Notchennie1/CDE2310_Group11/docs/Electrical work/System_Schematics.png

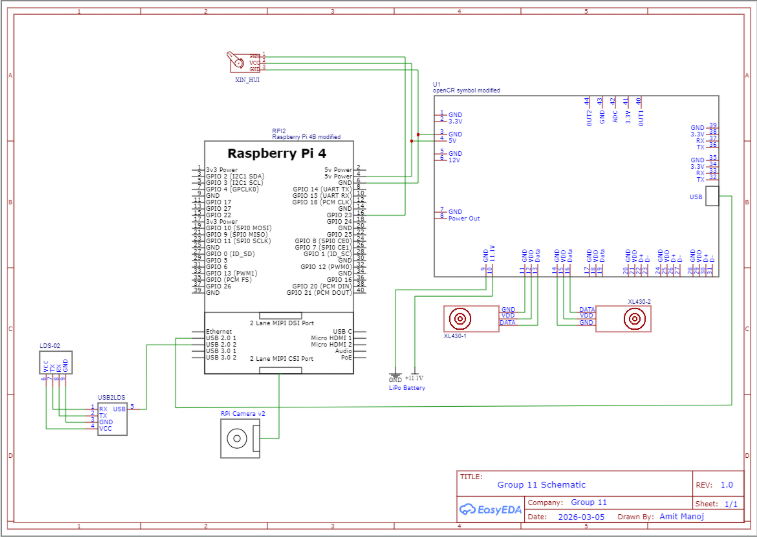
docs/Electrical work/System_Schematics.png
