Notchennie1/CDE2310_Group11/CAD/Turtlebot Assembly/Launcher Assembly.SLDASM

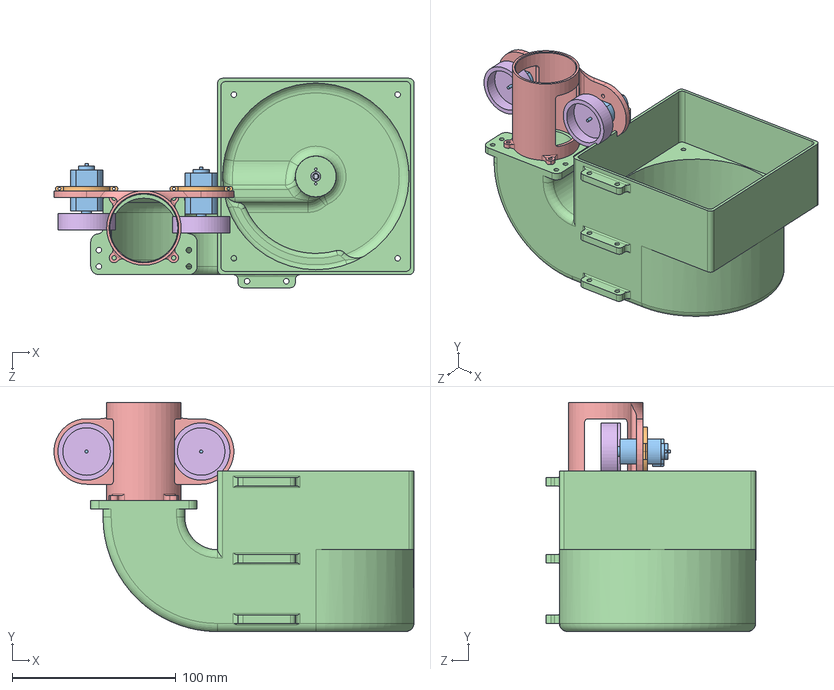
[picture p7: CAD file, 2026-04-19]
CAD/Turtlebot Assembly/Launcher Assembly.SLDASM
219.9 x 140.0 x 128.0 mm
Flywheel dummy x 2
Barrel guide
Carousell
Motor x 2
Motor Clamp x 2
Stepper Dummy
