Notchennie1/CDE2310_Group11/CAD/Turtlebot Assembly/Ball_Feeder_Full.SLDPRT

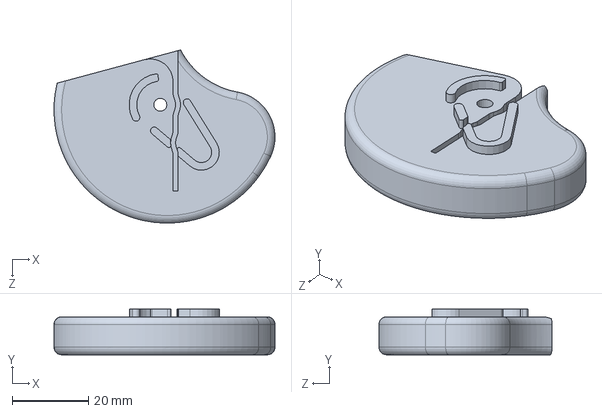
[picture p8: CAD file, 2026-04-19]
CAD/Turtlebot Assembly/Ball_Feeder_Full.SLDPRT
58.0 x 12.0 x 45.5 mm
