Notchennie1/CDE2310_Group11/CAD/Turtlebot Assembly/Motor_Support.SLDPRT

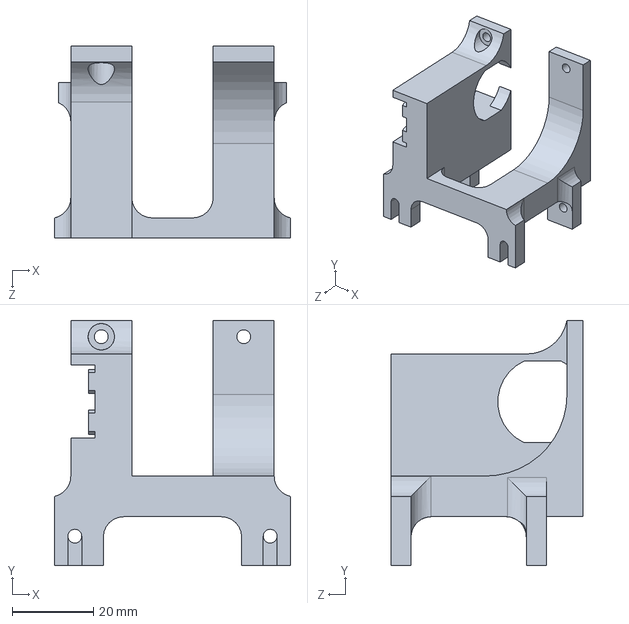
[picture p9: CAD file, 2026-04-19]
CAD/Turtlebot Assembly/Motor_Support.SLDPRT
58.0 x 60.2 x 47.3 mm
