Notchennie1/CDE2310_Group11/CAD/Turtlebot Assembly/PingPong_Ball.SLDPRT

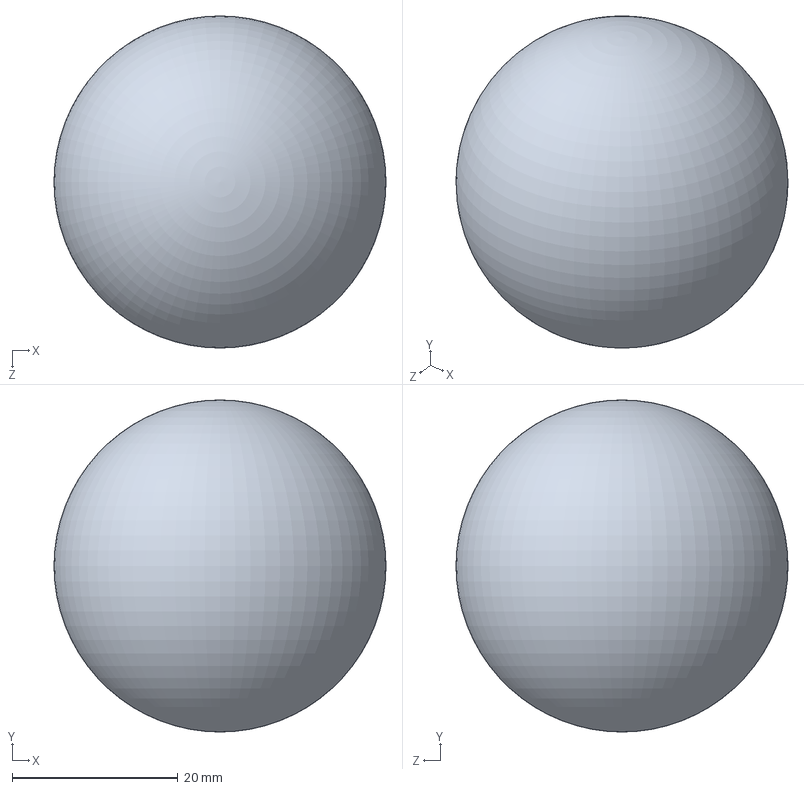
[picture p10: CAD file, 2026-04-19]
CAD/Turtlebot Assembly/PingPong_Ball.SLDPRT
40.0 x 40.0 x 40.0 mm
