Notchennie1/CDE2310_Group11/CAD/Turtlebot Assembly/Motor Clamp.SLDPRT

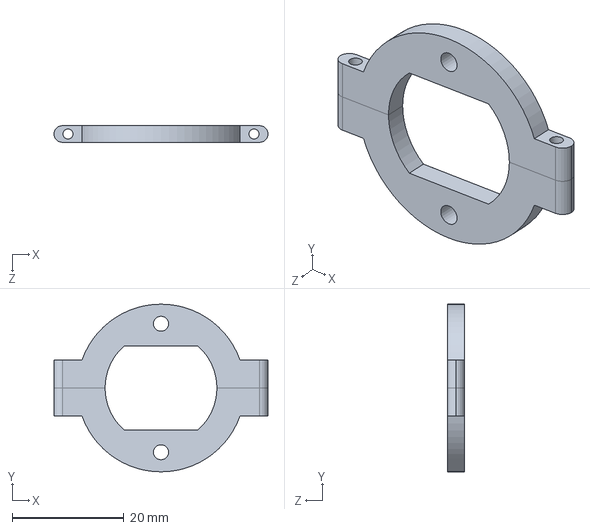
[picture p11: CAD file, 2026-04-19]
CAD/Turtlebot Assembly/Motor Clamp.SLDPRT
38.3 x 30.0 x 3.00 mm
