Notchennie1/CDE2310_Group11/CAD/Turtlebot Assembly/Clamp2.SLDPRT

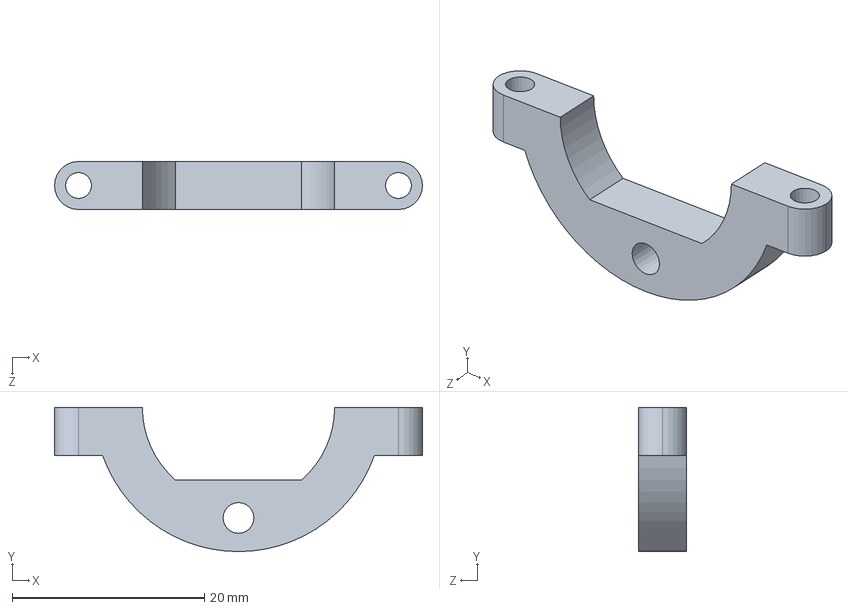
[picture p12: CAD file, 2026-04-19]
CAD/Turtlebot Assembly/Clamp2.SLDPRT
38.3 x 15.0 x 5.00 mm
