Notchennie1/CDE2310_Group11/CAD/Turtlebot Assembly/Raspberry_Dummy.SLDPRT

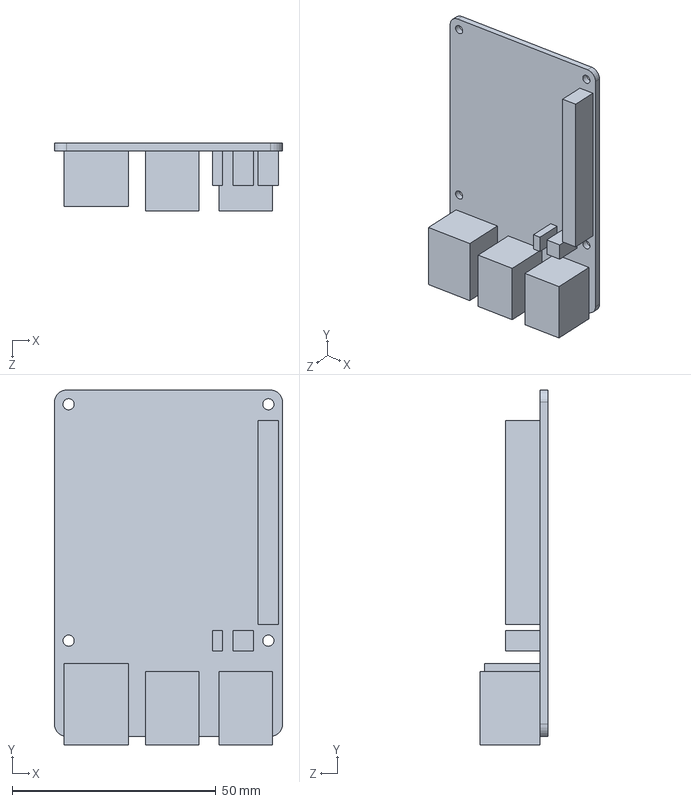
[picture p13: CAD file, 2026-04-19]
CAD/Turtlebot Assembly/Raspberry_Dummy.SLDPRT
56.0 x 87.1 x 16.8 mm
