Notchennie1/CDE2310_Group11/CAD/Turtlebot Assembly/Rotor.SLDPRT

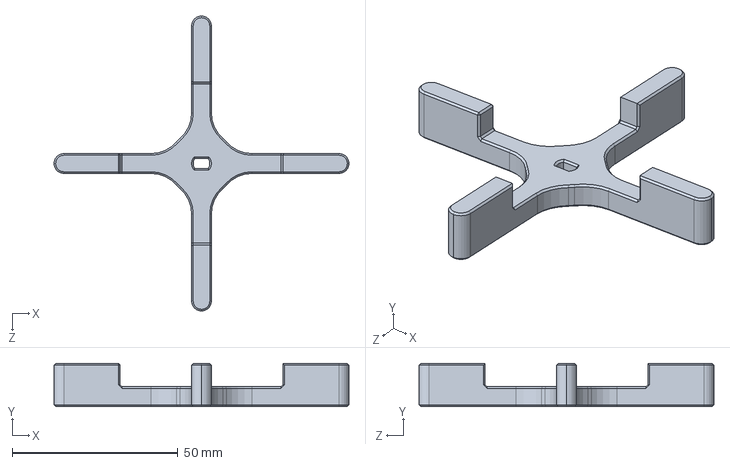
[picture p14: CAD file, 2026-04-19]
CAD/Turtlebot Assembly/Rotor.SLDPRT
89.1 x 13.0 x 89.1 mm
