Notchennie1/CDE2310_Group11/CAD/Turtlebot Assembly/New_Camera_Mount.SLDPRT

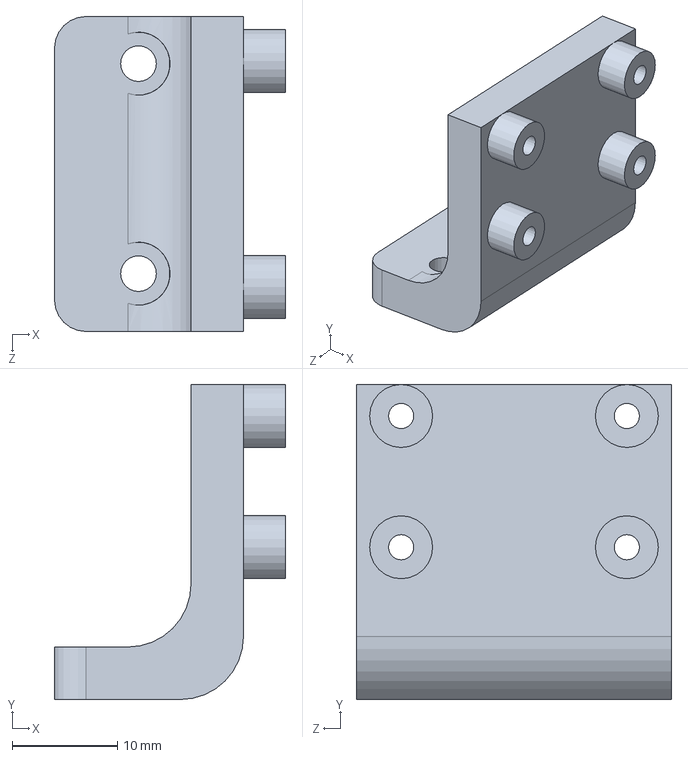
[picture p15: CAD file, 2026-04-19]
CAD/Turtlebot Assembly/New_Camera_Mount.SLDPRT
22.0 x 30.0 x 30.0 mm
