Notchennie1/CDE2310_Group11/CAD/Turtlebot Assembly/Clamp1.SLDPRT

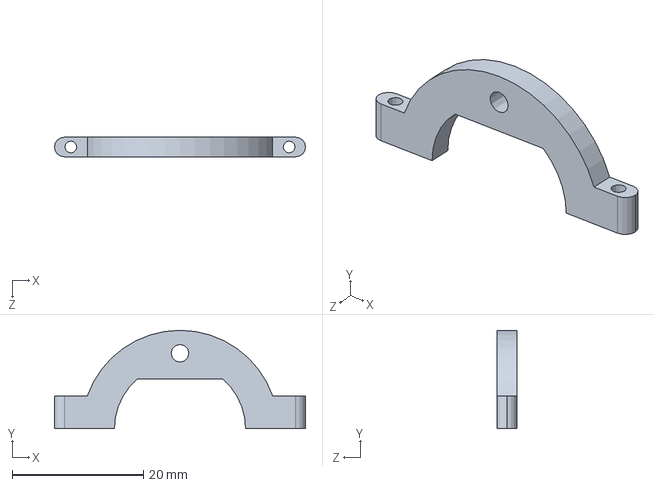
[picture p16: CAD file, 2026-04-19]
CAD/Turtlebot Assembly/Clamp1.SLDPRT
38.3 x 15.0 x 3.00 mm
