Notchennie1/CDE2310_Group11/CAD/Turtlebot Assembly/Stepper Dummy.SLDPRT

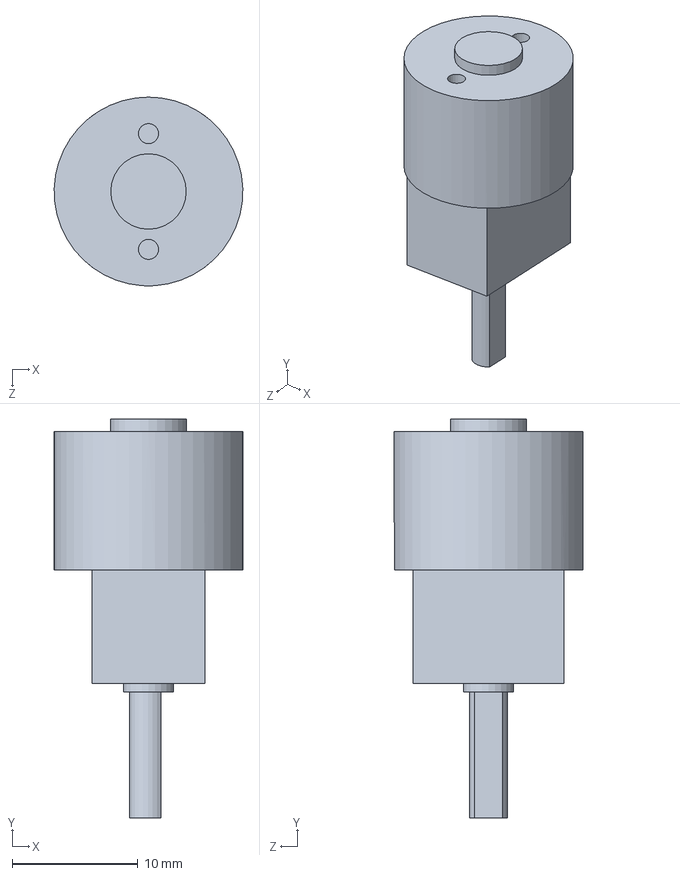
[picture p17: CAD file, 2026-04-19]
CAD/Turtlebot Assembly/Stepper Dummy.SLDPRT
15.0 x 31.7 x 15.0 mm
