Notchennie1/CDE2310_Group11/CAD/Turtlebot Assembly/LB-012 Battery.SLDPRT

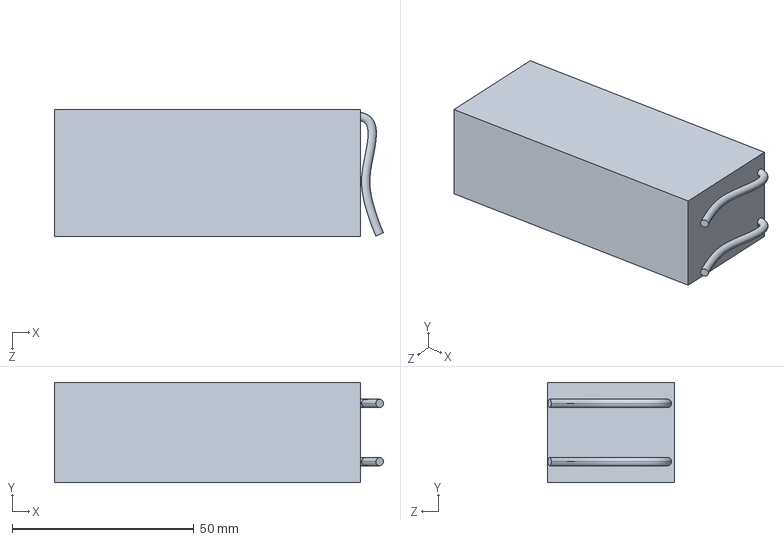
[picture p18: CAD file, 2026-04-19]
CAD/Turtlebot Assembly/LB-012 Battery.SLDPRT
90.4 x 27.5 x 35.0 mm
