Notchennie1/CDE2310_Group11/CAD/Turtlebot Assembly/Feed_Path.SLDPRT

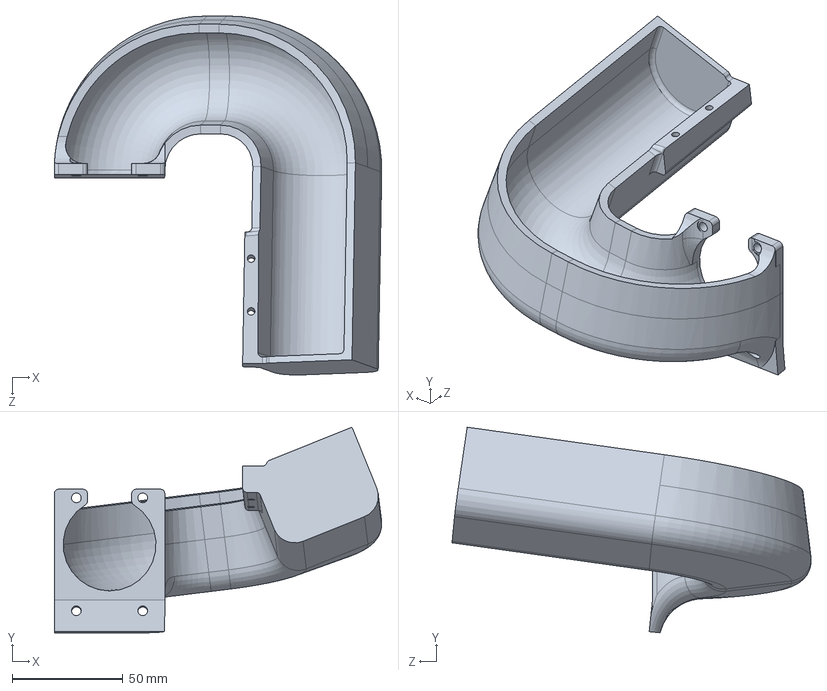
[picture p19: CAD file, 2026-04-19]
CAD/Turtlebot Assembly/Feed_Path.SLDPRT
148.1 x 93.0 x 162.3 mm
