Notchennie1/CDE2310_Group11/CAD/Turtlebot Assembly/Barrel guide.SLDPRT

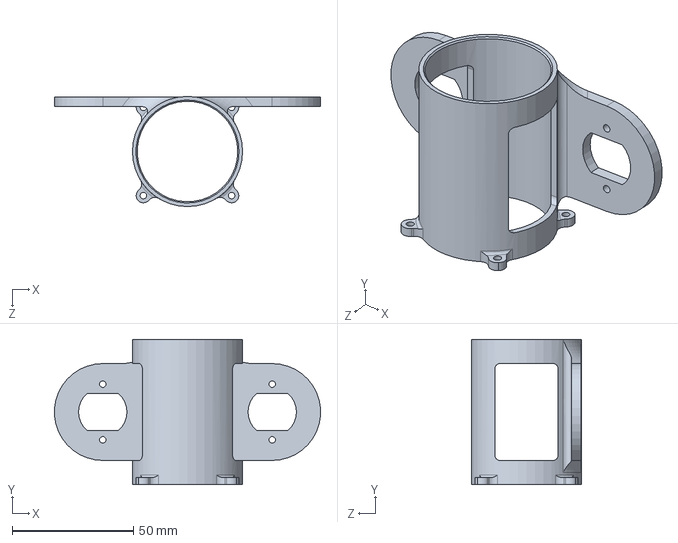
[picture p20: CAD file, 2026-04-19]
CAD/Turtlebot Assembly/Barrel guide.SLDPRT
109.9 x 60.0 x 45.5 mm
