Notchennie1/CDE2310_Group11/CAD/Turtlebot Assembly/Barrel.SLDPRT

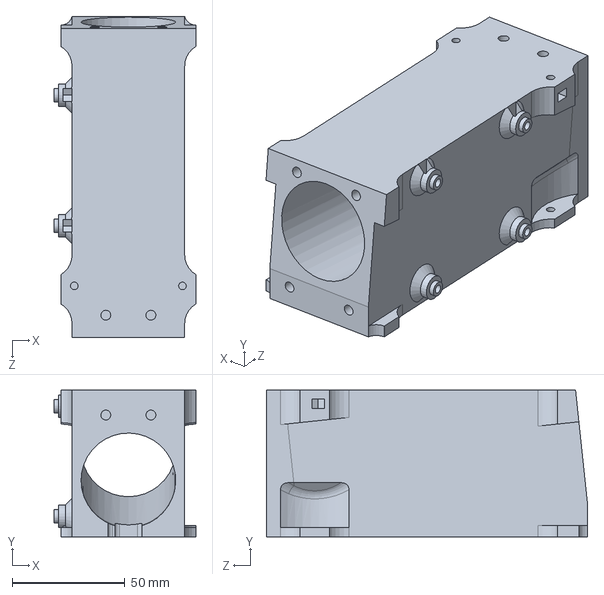
[picture p21: CAD file, 2026-04-19]
CAD/Turtlebot Assembly/Barrel.SLDPRT
63.0 x 65.0 x 142.6 mm
