Notchennie1/CDE2310_Group11/CAD/Turtlebot Assembly/Part 3.SLDPRT

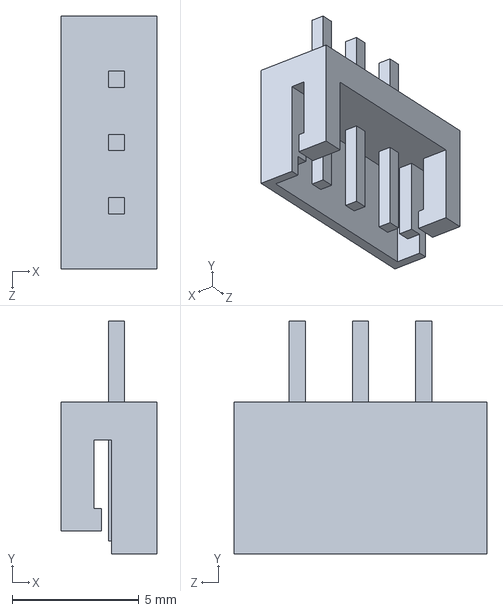
[picture p22: CAD file, 2026-04-19]
CAD/Turtlebot Assembly/Part 3.SLDPRT
3.80 x 9.20 x 10.00 mm
