Notchennie1/CDE2310_Group11/CAD/Turtlebot Assembly/Layor_Support.SLDPRT

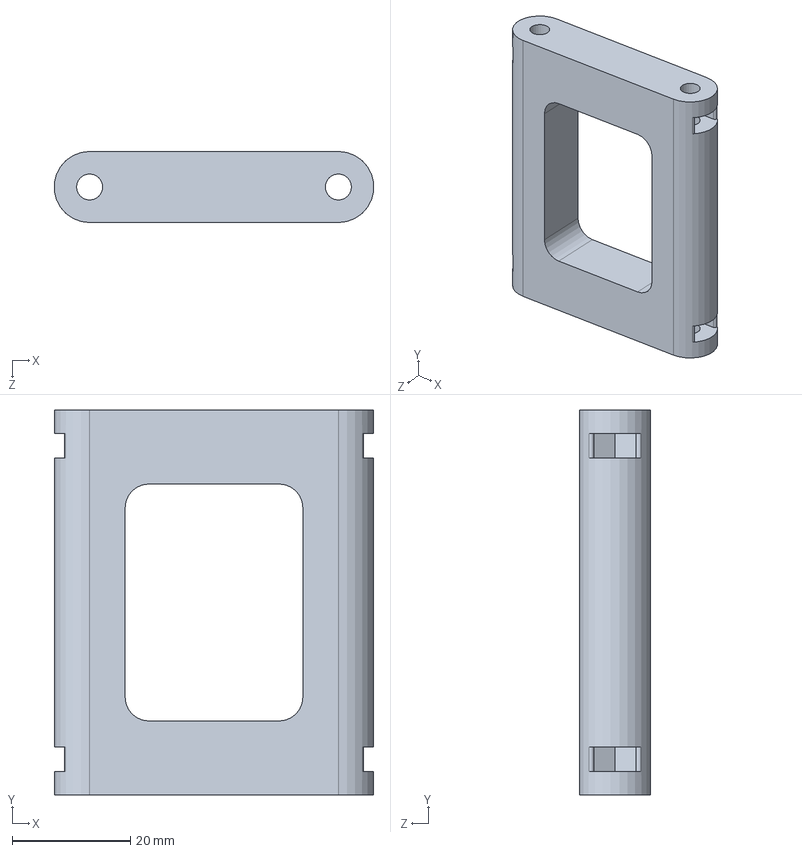
[picture p23: CAD file, 2026-04-19]
CAD/Turtlebot Assembly/Layor_Support.SLDPRT
53.9 x 65.0 x 12.0 mm
