Notchennie1/CDE2310_Group11/CAD/Turtlebot Assembly/Carousell.SLDPRT

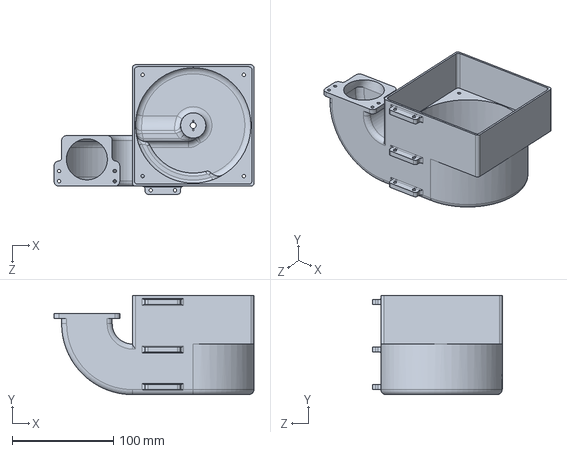
[picture p24: CAD file, 2026-04-19]
CAD/Turtlebot Assembly/Carousell.SLDPRT
197.5 x 98.0 x 128.0 mm
