Notchennie1/CDE2310_Group11/CAD/Turtlebot Assembly/Motor.SLDPRT

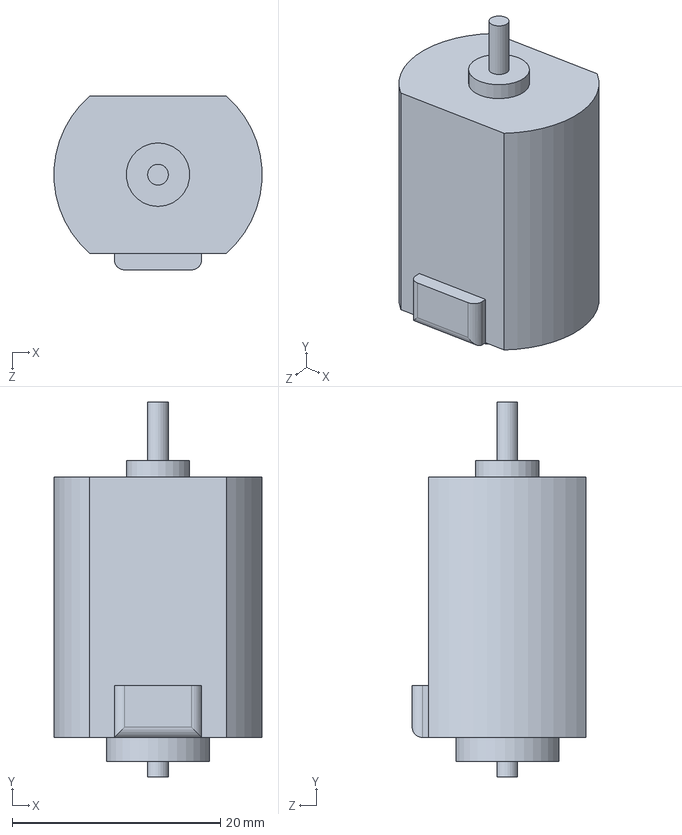
[picture p25: CAD file, 2026-04-19]
CAD/Turtlebot Assembly/Motor.SLDPRT
20.0 x 36.0 x 16.7 mm
