Notchennie1/CDE2310_Group11/CAD/Turtlebot Assembly/Waffle Plate.SLDPRT

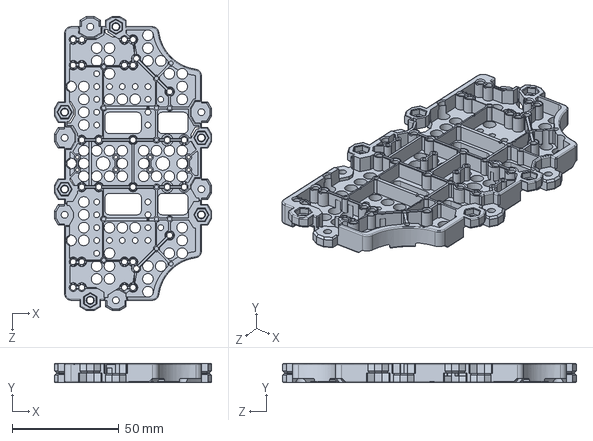
[picture p26: CAD file, 2026-04-19]
CAD/Turtlebot Assembly/Waffle Plate.SLDPRT
73.5 x 9.00 x 137.5 mm
