Notchennie1/CDE2310_Group11/CAD/Turtlebot Assembly/motor dummy.SLDPRT

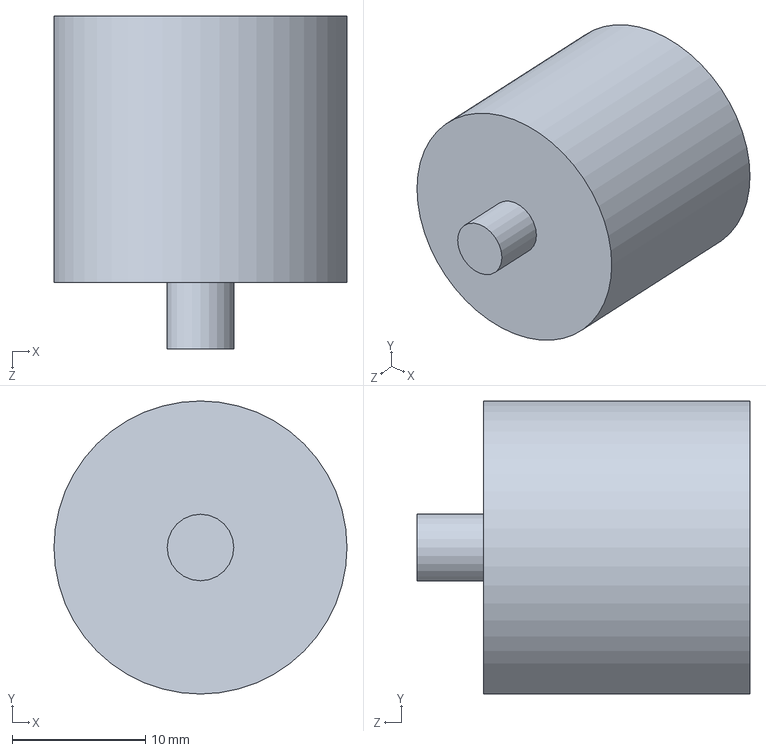
[picture p27: CAD file, 2026-04-19]
CAD/Turtlebot Assembly/motor dummy.SLDPRT
22.0 x 22.0 x 25.0 mm
