Notchennie1/CDE2310_Group11/CAD/Turtlebot Assembly/Flywheel dummy.SLDPRT

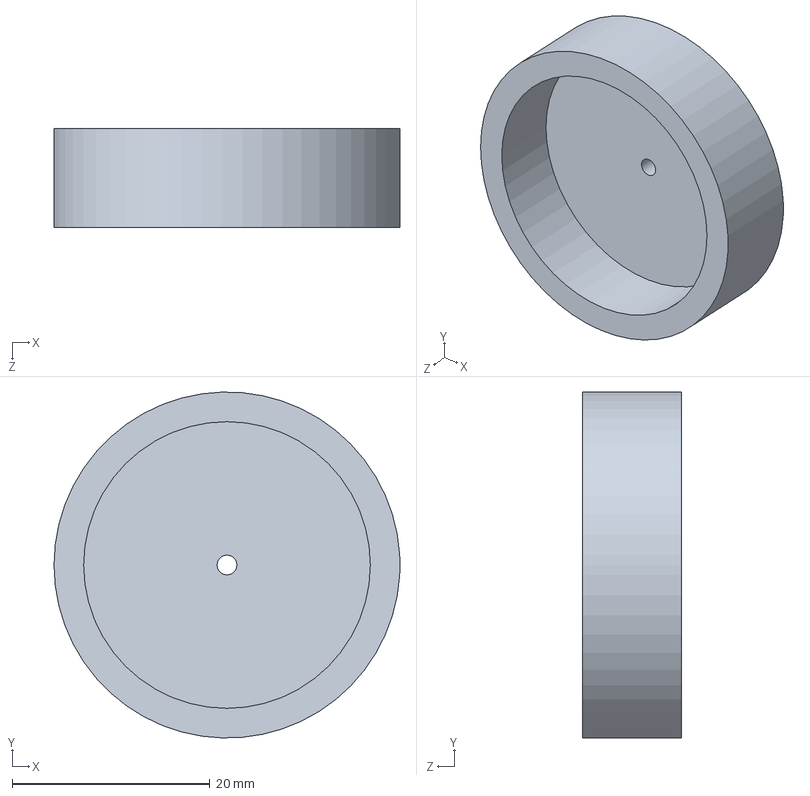
[picture p28: CAD file, 2026-04-19]
CAD/Turtlebot Assembly/Flywheel dummy.SLDPRT
35.0 x 35.0 x 10.0 mm
