Notchennie1/CDE2310_Group11/CAD/Turtlebot Assembly/Muzzle.SLDPRT

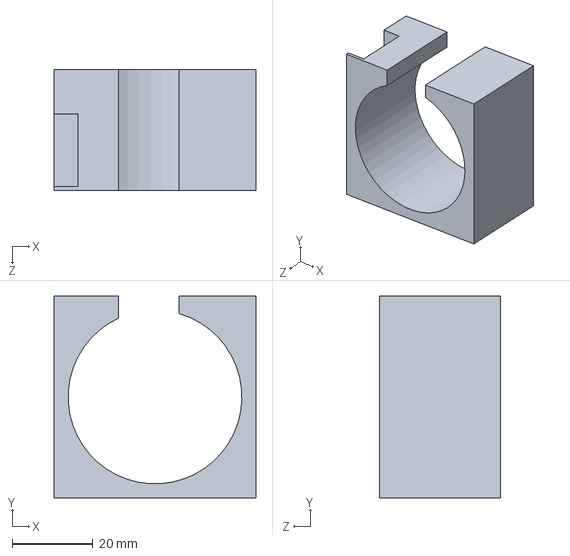
[picture p29: CAD file, 2026-04-19]
CAD/Turtlebot Assembly/Muzzle.SLDPRT
50.0 x 50.0 x 30.0 mm
