Notchennie1/CDE2310_Group11/CAD/Turtlebot Assembly/First Layer.SLDASM

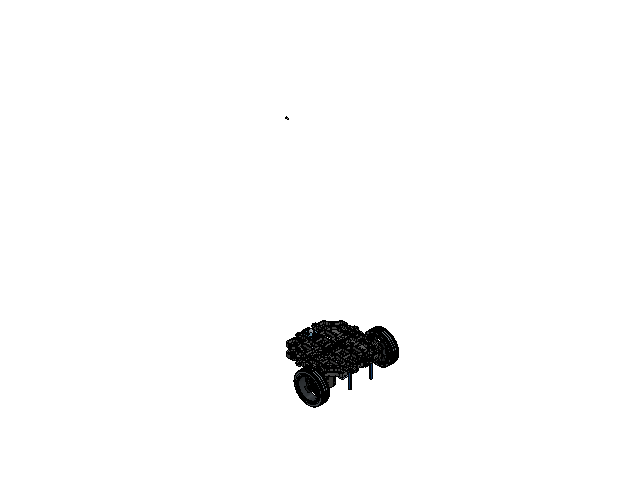
[picture p30: CAD file, 2026-04-19]
CAD/Turtlebot Assembly/First Layer.SLDASM
STEELBALL_3_8INCH
PR21_CASTER_CVR_3X5_REV6
P30_ISP_A001_3D x 2
PR16_A01_TIRE_2 x 2
M_PR07_A01_BRACKET_2 x 5
SUPPORT_HEX_M3_0XL35_FF x 4
Waffle Plate x 2
pan cross head_ks x 28
hexagon nut style 1 gradeab_ks x 4
LB-012 Battery
