Notchennie1/CDE2310_Group11/CAD/Turtlebot Assembly/Waffle Layer2.SLDASM

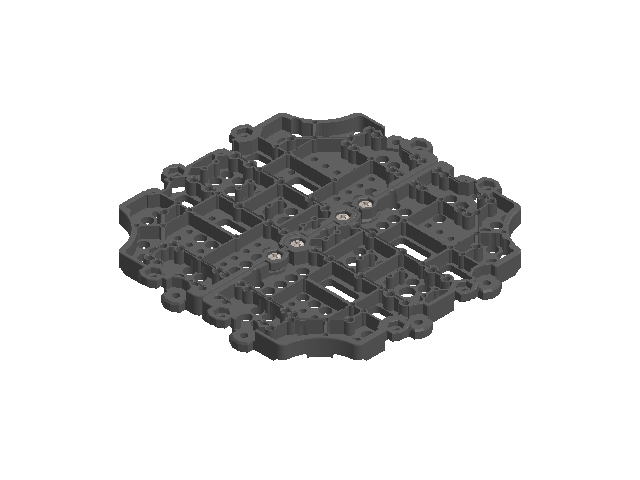
[picture p31: CAD file, 2026-04-19]
CAD/Turtlebot Assembly/Waffle Layer2.SLDASM
Waffle Plate x 2
pan cross head_ks x 4
hexagon nut style 1 gradeab_ks x 4
