Notchennie1/CDE2310_Group11/CAD/Turtlebot Assembly/Second Layer.SLDASM

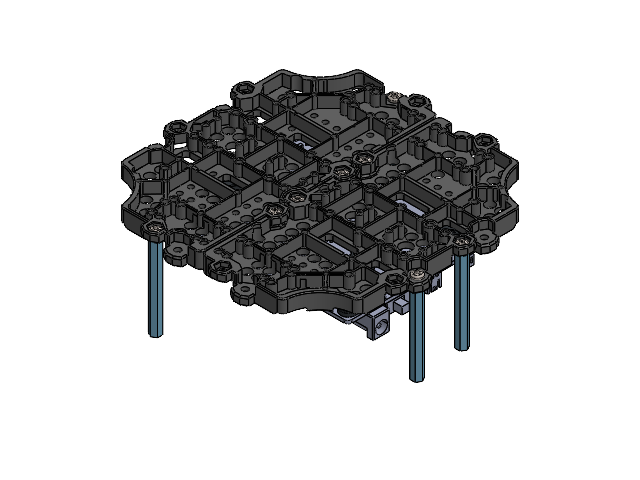
[picture p32: CAD file, 2026-04-19]
CAD/Turtlebot Assembly/Second Layer.SLDASM
Waffle Plate x 2
pan cross head_ks x 8
hexagon nut style 1 gradeab_ks x 6
PR30_IBB_01_3D x 2
SUPPORT_HEX_M3_0XL45_FF x 4
OPENCR Dummy
