Notchennie1/CDE2310_Group11/CAD/Turtlebot Assembly/MG996R Servo Motor.SLDASM

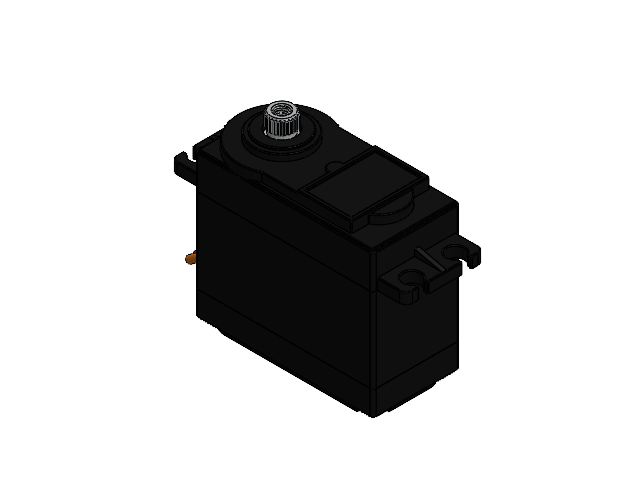
[picture p33: CAD file, 2026-04-19]
CAD/Turtlebot Assembly/MG996R Servo Motor.SLDASM
Case-1
Output Shaft-1
Rubber Wire Cable Sleeve-1
Pan Head Cross Screw M1.6-1 x 4
