Notchennie1/CDE2310_Group11/CAD/Turtlebot Assembly/Dynamixel Motor.SLDASM

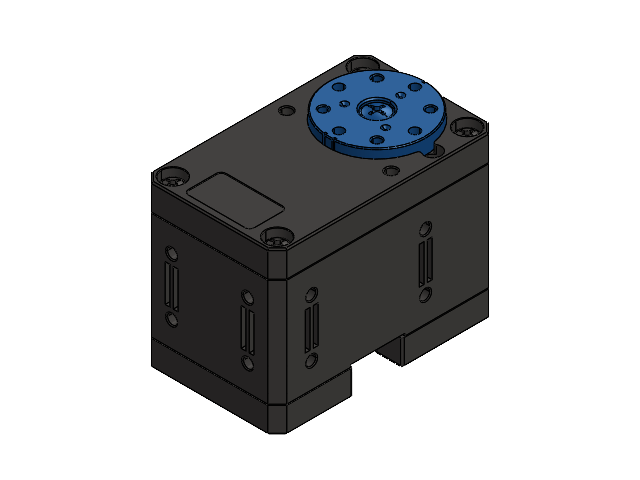
[picture p34: CAD file, 2026-04-19]
CAD/Turtlebot Assembly/Dynamixel Motor.SLDASM
