Notchennie1/CDE2310_Group11/CAD/Turtlebot Assembly/Third Layer.SLDASM

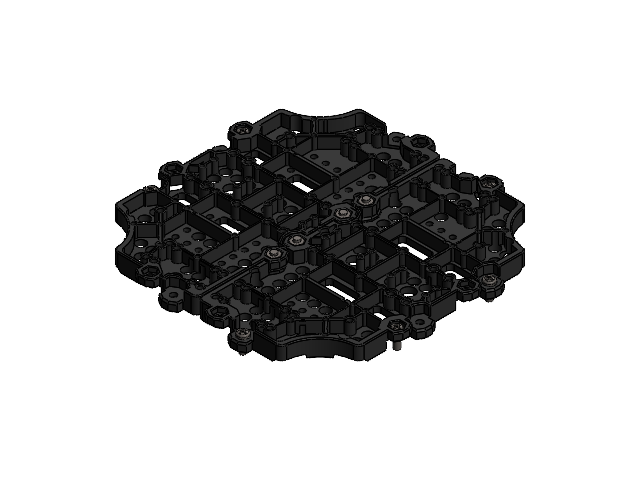
[picture p36: CAD file, 2026-04-19]
CAD/Turtlebot Assembly/Third Layer.SLDASM
Waffle Plate x 2
pan cross head_ks x 10
hexagon nut style 1 gradeab_ks x 4
