Notchennie1/CDE2310_Group11/(list of files, cad)

Other CAD files:
CAD/Turtlebot Assembly/ball_caster _1_.SLDASM
CAD/Turtlebot Assembly/wheel _1_.SLDASM
CAD/Turtlebot Assembly/PR21_CASTER_CVR_3X5_REV6.SLDPRT
CAD/Turtlebot Assembly/Servo Horns(6 Horns).SLDPRT
CAD/Turtlebot Assembly/Servo Horns(Circular Horn).SLDPRT
CAD/Turtlebot Assembly/PR30_IBB_01_3D-10.SLDPRT
CAD/Turtlebot Assembly/PR30_IBB_01_3D.SLDPRT
CAD/Turtlebot Assembly/P30_ISP_A001_3D.SLDPRT
CAD/Turtlebot Assembly/Output Shaft-1.SLDPRT
CAD/Turtlebot Assembly/Servo Horns(1 Horn).SLDPRT
CAD/Turtlebot Assembly/Servo Horns(4 Horns).SLDPRT
CAD/Turtlebot Assembly/SUPPORT_HEX_M3_0XL45_FF.SLDPRT
CAD/Turtlebot Assembly/Part 2-12.SLDPRT
CAD/Turtlebot Assembly/Servo Horns(2 Horns).SLDPRT
CAD/Turtlebot Assembly/M_PR07_A01_SPACER_RIVET.SLDPRT
CAD/Turtlebot Assembly/Rubber Wire Cable Sleeve-1.SLDPRT
CAD/Turtlebot Assembly/Case-1.SLDPRT
CAD/Turtlebot Assembly/Part 1-14.SLDPRT
CAD/Turtlebot Assembly/M_PR07_A01_BRACKET_2.SLDPRT
CAD/Turtlebot Assembly/PR16_A01_TIRE_2.SLDPRT
CAD/Turtlebot Assembly/SUPPORT_HEX_M3_0XL35_FF.SLDPRT
CAD/Turtlebot Assembly/STEELBALL_3_8INCH.SLDPRT
CAD/Turtlebot Assembly/Pan Head Cross Screw M1.6-1.SLDPRT
CAD/Turtlebot Assembly/Pan Head Cross Screw M3-1.SLDPRT
CAD/Turtlebot Assembly/Raspberry_Dummy1.ipt
CAD/Turtlebot Assembly/Waffle Plate.ipt
