Notchennie1/CDE2310_Group11/(commit log)

2026-01-16 servo spin direction
2026-04-09 Remove obsolete source files and resolve merge artifacts
    [Task_A_Main.py, Task_B_Main.py, aruco_detection.py, aruco_detection_PNP.py, docking_main.py]
2026-04-09 Add MG996R class for servo control
2026-04-11 removed camera offset
2026-04-11 small terminal log issue fixed
    [docking_base.py]
2026-04-13 changed servo.fire call method
2026-04-15 speed stall issue
2026-04-19 added all CAD files
    [Ball_Feeder_Full.SLDPRT, Barrel guide.SLDPRT, Barrel.SLDPRT, Carousell.SLDPRT, Case-1.SLDPRT, Clamp1.SLDPRT, Clamp2.SLDPRT, Dynamixel Motor.SLDASM]
